KK153402/RP2040_FamicomRomdumper/docs/hardware.md

# ハードウェア仕様 / Hardware Specification（rev2）

RP2040ベースのファミコンROMダンパー（rev2基板、Booth販売用）の部品表・全接続・電源設計。**配線に関してはこの文書を正とする。**

- 組み立て後の動作確認〜ダンプ手順 → [bringup.md](bringup.md)
- 設計判断の理由と技術解説 → [design-notes.md](design-notes.md)
- シリアルコマンド仕様 → [protocol.md](protocol.md)
- rev1の既知の問題 → [../hardware/ERRATA.md](../hardware/ERRATA.md)

---

## rev1からの変更点（概要）

| 項目 | rev1 | rev2 | 理由 |
|---|---|---|---|
| MCU | ESP32-WROOM-32E DevKit | **秋月 AE-RP2040**（U13） | 無線なしで技適が不要。ネイティブUSBでドライバ不要。PIOで高速化できる |
| USB | DevKitのmicroUSB＋USB-シリアルIC | AE-RP2040のType-C（USB CDC） | Web Serialから直接使える |
| カート電源 | 旧SW1（手動スライドスイッチ） | **TPS2051C（U14）をGPIO制御** | 電源シーケンスをファームで強制する。過電流保護 |
| 過電流保護 | なし | TPS2051C（IOS 0.65〜1.05 A）＋ `CART_FLT_N` でアプリへ通知 | 故障カセット・逆挿しからUSBポートを守る |
| カート電源の監視 | なし | `VCART_SENSE`（ADC、R35/R36） | ON確認と、抜去前の放電確認 |
| 状態表示LED | なし | `LED_STATUS`（GPIO） | AE-RP2040にLEDがないため |
| `VCC_CART` 出口コンデンサ | 10 µF | **22 µF**（3216、16 V以上） | DCバイアス後の実効10 µFを確保（§9.4） |
| J1:31 | NC（ソルダージャンパ案のみ） | **SW1（SK-12D11VG3）で `VCC_CART` へ接続。出荷時ON** | ERRATA対応 |
| J1 ネット表 | ピン48の記載誤り（49が重複） | 48 = `CIRAM_CE_N_5V`、49 = `PPU_A13_N_5V` に修正 | 誤記 |

**74系IC（U1〜U12）とその周辺は rev1 から変更なし。** RP2040のI/Oは3.3 Vで5 Vトレラントではないため、レベル変換の構成はそのまま必要。

---

## 0. ネット命名規則

**74HCT244を挟む6本の制御線は、入力側と出力側で必ず別のネット名にすること。** 同名にすると、回路図上で意図せず1本に繋がっても気づけない。

| MCU側（3.3 V） | U9 経路 | カート側（5 V） | J1 |
|---|---|---|---|
| `M2_3.3V` | 1A1(2) → 1Y1(18) | `M2_5V` | 32 |
| `ROMSEL_N_3.3V` | 1A2(4) → 1Y2(16) | `ROMSEL_N_5V` | 44 |
| `RW_3.3V` | 1A3(6) → 1Y3(14) | `RW_5V` | 14 |
| `PPU_RD_N_3.3V` | 1A4(8) → 1Y4(12) | `PPU_RD_N_5V` | 17 |
| `PPU_WR_N_3.3V` | 2A1(11) → 2Y1(9) | `PPU_WR_N_5V` | 47 |
| `PPU_A13_N_3.3V` | 2A2(13) → 2Y2(7) | `PPU_A13_N_5V` | 49 |

**この12個のネットに同じノードが2つ入ってはいけない。** ERCでは検出できないので、ネットリスト出力後に目視確認すること（§11）。

### KiCadでの注意

- **ネット名に `/` を使わない。** KiCadでは階層パスの区切り文字として解釈され、ネットリスト上で `{slash}` に化ける。負論理は `_N` サフィックスで表現する（`/IRQ` ではなく `IRQ_N`）
- 電源レールは `+5V` `+3.3V` `VCC_CART` の3つ。**`VCC_CART` を `+5V` と同名にしない**

---

## 1. 実装方式

自作PCB（JLCPCB等）。ネット数が約120本あるため、ユニバーサル基板での手配線は想定しない。

---

## 2. 部品表（発注用）

### 2.1 必須部品

| # | 参照 | 部品 | 型番 | 数量 | 備考 |
|---|---|---|---|---|---|
| 1 | J1 | 60ピン カートリッジスロット | ファミコン補修用 | 1 | §3。**最も納期が長い** |
| 2 | U1–U6 | 8bitシフトレジスタ（出力） | **SN74AHCT595D**（SOIC-16） | 6 | **AHCではなくAHCT**。§2.3 |
| 3 | U7–U8 | 8bitシフトレジスタ（入力） | CD74HCT165M（SOIC-16） | 2 | AHCTファミリに `'165` は存在しない |
| 4 | U9 | オクタルバッファ | SN74AHCT244D / SN74HCT244DW | 1 | 「T」を確認 |
| 5 | U10–U12 | 1bitレベル変換 | SN74LVC1T45DBVR（SOT-23-6） | 3 | 5→3.3 V |
| 6 | U13 | RP2040ボード | **秋月 AE-RP2040**（販売コード117542） | 1 | §5 |
| 7 | U14 | 電流制限付き電源スイッチ | **TPS2051CDBVR**（SOT-23-5） | 1 | §9.3。**TPS2051C-2（放電なし）ではないこと** |
| 8 | R1–R23, R26–R34, R37, R38 | 抵抗 10 kΩ | 1608 | 34 | 内訳は§6 |
| 9 | R35, R36 | 抵抗 10 kΩ（1%推奨、5%品でも可） | 1608 | 2 | `VCART_SENSE` 分圧。§6.5 |
| 10 | R24, R25, R39 | 抵抗 1 kΩ | 1608 | 3 | LED電流制限 |
| 11 | C1–C13, C17–C20 | セラコン 0.1 µF | 1608 | 17 | U1–U12各1個＋U14 IN＋U10–U12 VCCB（C17–C19）＋J1:30直近（C20） |
| 12 | C14 | 積セラ 10 µF | 2012以上、16 V以上 | 1 | `+5V` 入口 |
| 13 | C15 | 積セラ **22 µF** | **3216、X5R/X7R、16 V以上** | 1 | `VCC_CART`（U14 OUT直近）。§9.4 |
| 14 | C16 | 積セラ 10 µF | 1608以上、10 V以上 | 1 | `+3.3V` 入口 |
| 15 | D1–D3 | LED | 1608または3 mm | 3 | `+5V` 表示 / `VCC_CART` 表示 / 状態表示 |
| 16 | SW1 | スライドスイッチ SPDT | SK-12D11VG3 | 1 | J1:31 ↔ `VCC_CART`。2=コモン（J1:31）、1=`VCC_CART`、3=NC。出荷時ON |

### 2.2 任意部品

| # | 部品 | 型番 | 数量 | 備考 |
|---|---|---|---|---|
| 17 | ピンヘッダ 1×N | 2.54 mm | 2 | AE-RP2040の実装用。キット付属分で足りるか要確認 |
| 18 | ピンソケット 1×N | 2.54 mm | 2 | AE-RP2040を着脱式にする場合（試作向き） |
| 19 | テストポイント | — | 10〜 | §5.3の空きGPIOと主要ネット |

### 2.3 発注時の最重要注意：入力しきい値に「T」が必要

**74HC595 や 74AHC595 を買うと動かない。** 必ず末尾に **T** の付く **HCT / AHCT** を発注すること。

| シリーズ | VCC = 5 V時の VIH | RP2040の3.3 V出力 |
|---|---|---|
| 74HC | 3.5 V | **認識されない（設計不成立）** |
| 74AHC | 3.85 V | **認識されない（設計不成立）** |
| 74HCT | 2.0 V | 確実に認識される |
| 74AHCT | 2.0 V | 確実に認識される |

**DigiKeyの検索結果では `SN74AHCT595D` と `SN74AHC595D` が隣接表示される。** 型番の「T」を目視確認すること。

AHCTはHCTより立ち上がりが速く（1〜2 ns）、8出力同時スイッチング時のグランドバウンスが大きい。0.1 µFのパスコンをIC直下に置き、バルクコンデンサを省略しないこと。HCTとAHCTの混在は問題ない（どちらも5 V電源・TTLしきい値）。

### 2.4 74HCT165 が入手できない場合

SN74LVC165A を VCC = 3.3 V で使う。LVCは入力が5.5 Vまで許容されるため5 Vのデータバスを直接読め、出力も3.3 Vなので **U10が不要**になる。採用する場合はU7:QHを `MISO`（GP7）へ直結し、U7/U8の電源を `+3.3V` に接続する。

---

## 3. 60ピン カートリッジスロットの調達

**代替の効かない部品。最優先で発注すること。**

| 項目 | 値 |
|---|---|
| ピッチ | 2.54 mm（0.1インチ） |
| 極数 | 30ポジション × 2列 = 60接点 |
| 受け入れ基板厚 | 0.062インチ（1.57〜1.6 mm） |
| 全長 | 約83 mm |

販売品は抜き差し回数が多いため、**接点品質と保持力を優先して選ぶ**。ファミコン補修用スロット（eBay / AliExpress、2〜4週間）を第一候補とし、ロットごとに既知のカセットで抜き差し試験をする。

---

## 4. IC一覧と役割

| 参照 | 型番 | 役割 | VCC |
|---|---|---|---|
| U1 | 74AHCT595 | CPU A7–A0 | +5V |
| U2 | 74AHCT595 | CPU A14–A8 | +5V |
| U3 | 74AHCT595 | PPU A7–A0 | +5V |
| U4 | 74AHCT595 | PPU A13–A8 | +5V |
| U5 | 74AHCT595 | CPU D7–D0（書き込み用） | +5V |
| U6 | 74AHCT595 | PPU D7–D0（書き込み用） | +5V |
| U7 | 74HCT165 | CPU D7–D0（読み出し） | +5V |
| U8 | 74HCT165 | PPU D7–D0（読み出し） | +5V |
| U9 | 74AHCT244 | 制御線6本 3.3→5 V | +5V |
| U10 | 74LVC1T45 | U7のQH 5→3.3 V | A:+3.3V / B:+5V |
| U11 | 74LVC1T45 | CIRAM A10 5→3.3 V | 同上 |
| U12 | 74LVC1T45 | CIRAM /CE 5→3.3 V | 同上 |
| U13 | AE-RP2040 | 制御、USB | 5V端子から給電 |
| U14 | TPS2051C | `VCC_CART` の開閉、過電流保護 | IN:+5V |

**U5とU6は必ず分ける。** 1個の595でCPU D0–D7とPPU D0–D7の両方を駆動すると、2本の独立したバスネットが恒久的に短絡する。

**マッパー対応（バンク切替）に必要な書き込み経路は U5/U6・R/W・/ROMSEL・M2・PPU /WR で既に揃っている。** 追加部品は不要。

### デイジーチェーン構成（rev1と同一）

```
アドレス系： MOSI → U1:SER(14)
             U1:QH'(9) → U2:SER(14) → U2:QH'(9) → U3:SER(14) → U3:QH'(9) → U4:SER(14)
             U4:QH'(9) は未接続（チェーン終端）
             RCLK は U1–U4 共通（RCLK_ADDR）

データ系：   MOSI → U5:SER(14)
             U5:QH'(9) → U6:SER(14)
             U6:QH'(9) は未接続
             RCLK は U5–U6 共通（RCLK_DATA）

読み出し系： U8:SER(10) = GND
             U8:QH(9) → U7:SER(10)
             U7:QH(9) → U10:B(4) → U10:A(3) → MISO
             /PL は U7–U8 共通（PL_165_N）

SRCLK / CP はすべてのIC（U1–U8）で SCK 共通
```

---

## 5. AE-RP2040（U13）

### 5.1 ボードの概要

| 項目 | 値 |
|---|---|
| MCU | RP2040（デュアルCortex-M0+、264 KB SRAM） |
| フラッシュ | 2 MB |
| GPIO | 30本すべて引き出し（GP0〜GP29） |
| USB | Type-C |
| 給電 | 5 V（オンボードレギュレータで3.3 V） |
| I/O電圧 | 3.3 V（**5 Vトレラントではない**） |
| 外形 | 44 × 21 mm |

### 5.1.1 ヘッダのピン配置（秋月 K-17542 ピン配置図より）

USBコネクタを上にして表から見た配置。2.54 mmピッチ、片側17ピン×2列の計34ピン。

| 左列 | 信号 | | 右列 | 信号 |
|---|---|---|---|---|
| 1 | +5V | | 34 | +3.3V |
| 2 | GP0 | | 33 | GND |
| 3 | GP1 | | 32 | GP29 |
| 4 | GP2 | | 31 | GP28 |
| 5 | GP3 | | 30 | GP27 |
| 6 | GP4 | | 29 | GP26 |
| 7 | GP5 | | 28 | GP25 |
| 8 | GP6 | | 27 | GP24 |
| 9 | GP7 | | 26 | GP23 |
| 10 | GP8 | | 25 | GP22 |
| 11 | GP9 | | 24 | GP21 |
| 12 | GP10 | | 23 | GP20 |
| 13 | GP11 | | 22 | GP19 |
| 14 | GP12 | | 21 | GP18 |
| 15 | GP13 | | 20 | GP17 |
| 16 | GP14 | | 19 | GP16 |
| 17 | GP15 | | 18 | GND |

下辺にSWD用のパッド（GND / SWDCLK / GND / SWDIO / RUN）がある。本基板では使わないが、書き込み治具を当てられるよう、**下辺の直下に部品を置かない**。

列間隔とヘッダ穴の位置は、秋月の「基板寸法図」から取ること。

**USB Type-Cが基板外形の縁に向くように配置する。** 筐体からケーブルを挿せる位置にすること。

### 5.2 ピン割り当て

PIOでまとめて扱えるよう、**用途ごとに連続したGPIOに割り当てている。** 順序を入れ替えるとファームのPIOプログラムが変わるので、変更する場合はファームと同時に直すこと。

| ヘッダ | GPIO | 信号名 | 接続先 | 方向 | PIOグループ |
|---|---|---|---|---|---|
| 4 | GP2 | `SCK` | U1–U8 の SRCLK(11) / CP(2) | OUT | side-set（連続4本） |
| 5 | GP3 | `PL_165_N` | U7–U8 の /PL(1) | OUT | side-set |
| 6 | GP4 | `RCLK_ADDR` | U1–U4 の RCLK(12) | OUT | side-set |
| 7 | GP5 | `RCLK_DATA` | U5–U6 の RCLK(12) | OUT | side-set |
| 8 | GP6 | `MOSI` | U1:SER(14)、U5:SER(14) | OUT | out |
| 9 | GP7 | `MISO` | U10:A(3) | IN | in |
| 10 | GP8 | `M2_3.3V` | U9:1A1(2) | OUT | 制御線（連続6本） |
| 11 | GP9 | `ROMSEL_N_3.3V` | U9:1A2(4) | OUT | 制御線 |
| 12 | GP10 | `RW_3.3V` | U9:1A3(6) | OUT | 制御線 |
| 13 | GP11 | `PPU_RD_N_3.3V` | U9:1A4(8) | OUT | 制御線 |
| 14 | GP12 | `PPU_WR_N_3.3V` | U9:2A1(11) | OUT | 制御線 |
| 15 | GP13 | `PPU_A13_N_3.3V` | U9:2A2(13) | OUT | 制御線 |
| 16 | GP14 | `OE_DATA_N` | U5–U6 の /OE(13) | OUT | — |
| 17 | GP15 | `BUS_EN_N` | U1–U4 の /OE(13)、U9 の 1/OE(1)・2/OE(19) | OUT | — |
| 19 | GP16 | `CIRAM_A10` | U11:A(3) | IN | — |
| 20 | GP17 | `CIRAM_CE_N` | U12:A(3) | IN | — |
| 21 | GP18 | `CART_PWR_EN` | U14:EN(4) | OUT | — |
| 22 | GP19 | `CART_FLT_N` | U14:/FLT(3) | IN | — |
| 23 | GP20 | `LED_STATUS` | R39 → D3 | OUT | — |
| 29 | GP26 | `VCART_SENSE` | R35/R36 分圧点 | IN（ADC0） | — |

**配置上の意味**：74系ロジックへの信号（GP2〜GP15）はすべて**左列（ヘッダ4〜17）** に、電源制御・監視とCIRAM（GP16〜GP20、GP26）は**右列**にまとまる。U1〜U9は左列側に、U11/U12・U14は右列側に置くと配線が素直になる。

### 5.3 予約・空きピン

| GPIO | 扱い |
|---|---|
| GP0 / GP1（ヘッダ2 / 3） | **UART0（TX/RX）としてデバッグ用に予約。** テストポイントだけ出す。USB CDCが動かないときの切り分けに使う |
| GP21–GP25（ヘッダ24〜28）、GP27–GP29（ヘッダ30〜32） | 空き。テストポイントを置く |

RP2040にはESP32のようなストラップピンはない（BOOTSELはボード上のボタン）。GP0〜GP29のどれを使っても起動モードには影響しない。

### 5.4 電源端子

| ヘッダ | AE-RP2040の端子 | 接続先 | 備考 |
|---|---|---|---|
| 1 | +5V | `+5V` | **基板全体の5 V源**。VBUSからSBD経由 |
| 34 | +3.3V | `+3.3V` | U10–U12のVCCA、3.3 V側プル抵抗、R38 |
| 18, 33 | GND | GND | **両方とも接続する**。GND端子はこの2本だけなので、それぞれ太いパターンとビア複数でGNDプレーンへ |

### 5.4.1 VBUS → +5V のショットキーダイオード

AE-RP2040の回路図では、USB-C（CN5）のVBUSから**ショットキーバリアダイオード（SBD）を経由して** 5V端子に出ている。したがって `+5V` = VBUS − VF となる。

| 条件 | VBUS | VF（SBD、約0.3 A時の目安） | `+5V` |
|---|---|---|---|
| 一般的なPCのUSBポート | 5.0 V | 0.3〜0.4 V | **4.6〜4.7 V** |
| USB 2.0の下限 | 4.75 V | 0.4 V | **4.35 V** |

- 74HCT/AHCT・TPS2051Cの推奨VCCは4.5〜5.5 V。通常の条件では満たす。下限条件では仕様を割るが、HCT/AHCTの入力しきい値（TTLレベル、約1.4 V）はVCCにほとんど依存せず、RP2040の3.3 V出力に対する余裕は大きいので、動作上の問題は出にくい
- TPS2051CのUVLO（立ち上がり最大4.0 V）には余裕がある
- **出荷検査で `+5V` を実測する**（カート電源ON・ダンプ中）。4.5 V以上を合格基準とする
- 説明書には「PC本体のUSBポートに直接接続。バスパワーのUSBハブ経由は非推奨」と書く
- **SBDの電流定格を回路図で確認する。** 通常は最大約0.3 Aだが、カート短絡時はTPS2051Cの制限値（最大1.05 A）＋基板分で最大約1.2 Aが、/FLTで遮断するまでの最大12 ms流れる。定格1 A品でも、この程度のパルスなら通常は問題ない

### 5.5 リセット中の状態

RP2040のGPIOはリセット直後、**入力・内部プルダウン有効**（RP2040データシート PADS_BANK0：PDE=1、PUE=0。内部プルダウンは約50〜80 kΩ）になっている。ファームが起動するまでの間に信号が不定にならないよう、外付け抵抗で状態を決める（§6）。

10 kΩのプルアップと内部プルダウンが競合した場合の電圧（プルダウン最小50 kΩで計算）：

V = 3.3 V × 50 kΩ ÷ (10 kΩ + 50 kΩ) = **2.75 V**

接続先は74AHCT/HCTの入力（VIH = 2.0 V）なので、Hとして確実に認識される。

### 5.6 USBの消費電流

| 状態 | 内訳 | 合計目安 |
|---|---|---|
| 接続直後（カート電源OFF） | RP2040約25 mA＋74系の静止電流 | 約30 mA |
| 動作中（カート電源ON） | 上記＋74系の動作電流100〜150 mA＋カセット60〜115 mA | 最大約300 mA |

USB 2.0の上限500 mAに収まる。USBディスクリプタのbMaxPowerは500 mAとする（列挙前は100 mA以内に収まっている）。

---

## 6. 抵抗の配置

### 6.1 データバスのプルアップ（5 V側）

| 参照 | 値 | 接続 | 目的 |
|---|---|---|---|
| R1–R8 | 10 kΩ | `CPU_D0`–`CPU_D7` ↔ **`VCC_CART`** | オープンバス = `$FF` を明示検出 |
| R9–R16 | 10 kΩ | `PPU_D0`–`PPU_D7` ↔ **`VCC_CART`** | 同上 |

**吊り先は `+5V` ではなく `VCC_CART`。** `+5V` に吊ると、カート電源をOFFにしても16本の10 kΩ経由で無電源のカセットへ電流が流れ込み（1本あたり約0.4 mA）、カート側の保護ダイオード経由でVCCが弱く逆給電される。

### 6.2 244 入力側の整定（3.3 V側）

**RP2040のリセット中はGPIOが入力（内部プルダウン）になるため、外付け抵抗で非アクティブ側に確定させる。**

| 参照 | 値 | ネット | 接続先 |
|---|---|---|---|
| R17 | 10 kΩ | `M2_3.3V` | **GND**（L = 非アクティブ） |
| R26 | 10 kΩ | `ROMSEL_N_3.3V` | **+3.3V** |
| R27 | 10 kΩ | `RW_3.3V` | **+3.3V**（H = リード） |
| R28 | 10 kΩ | `PPU_RD_N_3.3V` | **+3.3V** |
| R29 | 10 kΩ | `PPU_WR_N_3.3V` | **+3.3V** |
| R30 | 10 kΩ | `PPU_A13_N_3.3V` | **+3.3V** |

### 6.3 244 出力側の整定（5 V側）

**`BUS_EN_N` でU9をHi-Zにしたとき、カート側の制御線が浮くのを防ぐ。**

| 参照 | 値 | ネット | 接続先 |
|---|---|---|---|
| R32 | 10 kΩ | `M2_5V` | **GND** |
| R18 | 10 kΩ | `ROMSEL_N_5V` | **`VCC_CART`** |
| R19 | 10 kΩ | `RW_5V` | **`VCC_CART`** |
| R20 | 10 kΩ | `PPU_RD_N_5V` | **`VCC_CART`** |
| R21 | 10 kΩ | `PPU_WR_N_5V` | **`VCC_CART`** |
| R22 | 10 kΩ | `PPU_A13_N_5V` | **`VCC_CART`** |

**3.3 Vに吊ってはいけない。** Hi-Z時にカート側CMOSのVIH（VCC = 5 V時に3.5 V）を満たさない。**`+5V` ではなく `VCC_CART` に吊る**理由は§6.1と同じ。

### 6.3.1 CIRAM 2本のプルアップ

| 参照 | 値 | ネット | 接続先 |
|---|---|---|---|
| R33 | 10 kΩ | `CIRAM_A10_5V` | **`VCC_CART`** |
| R34 | 10 kΩ | `CIRAM_CE_N_5V` | **`VCC_CART`** |

U11:B(4) と U12:B(4) は入力ピンで、カート未挿入時に浮く。LVCの入力を浮かせると消費電流の増加と発振の原因になる。

### 6.4 MCU制御線・電源制御

| 参照 | 値 | ネット | 接続先 | 目的 |
|---|---|---|---|---|
| R23 | 10 kΩ | `OE_DATA_N` | **+3.3V** | リセット中はU5/U6をHi-Z |
| R31 | 10 kΩ | `BUS_EN_N` | **+3.3V** | リセット中はU1–U4・U9をHi-Z |
| R37 | 10 kΩ | `CART_PWR_EN` | **GND** | **リセット中はカート電源OFF** |
| R38 | 10 kΩ | `CART_FLT_N` | **+3.3V** | /FLTはオープンドレイン |
| R24 | 1 kΩ | `+5V` → D1 | — | `+5V` 電源表示 |
| R25 | 1 kΩ | `VCC_CART` → D2 | — | カート通電表示 |
| R39 | 1 kΩ | `LED_STATUS` → D3 | — | 状態表示 |

- **R23 / R31 は3.3 Vに吊る。** RP2040は5 Vトレラントでない
- **R37はプルダウン。** TPS2051CのENはアクティブH（データシート Table 5-2）。ENのしきい値は立ち上がりで1.0〜2.0 V（§6.7）なので、3.3 V出力でON、R37と内部プルダウンでOFFが確定する
- **R38は `+3.3V` に吊る。** `+5V` に吊ると、GP19に5 Vが入る
- LED電流：D1/D2 は (5 − 2) V ÷ 1 kΩ ≈ 3 mA、D3 は (3.3 − 2) V ÷ 1 kΩ ≈ 1.3 mA。D3が暗い場合はR39を470 Ωにする

### 6.5 `VCART_SENSE`（カート電源の監視）

| 参照 | 値 | 接続 |
|---|---|---|
| R35 | 10 kΩ 1% | `VCC_CART` → `VCART_SENSE` |
| R36 | 10 kΩ 1% | `VCART_SENSE` → GND |

分圧比1/2。`VCC_CART` = 5.5 V（USB上限）でも2.75 Vで、ADC入力の上限（IOVDD = 3.3 V）を超えない。

用途：

- ON後に `VCC_CART` ≥ 4.0 V（ADC読みで2.0 V以上）を確認してから `BUS_EN_N` = L にする

**判定しきい値は4.0 Vとする（4.5 Vにしない）。** `+5V` 自体がSBDの降下で4.6〜4.7 Vしかない（§5.4.1）。4.5 Vで判定すると、分圧抵抗の誤差（5%品で比率最大±5%）とADC基準（+3.3V）の誤差だけで正常品をNGにする。4.0 VならTPS2051CのUVLO（最大4.0 V）と揃い、電流制限中（出力電圧が大きく下がる）との区別には十分。

| 抵抗 | 分圧比の最悪誤差 | `VCC_CART` = 4.6 V時のADC読み | 4.0 V判定（2.0 V）の余裕 |
|---|---|---|---|
| 5%品 | ±5% | 2.18〜2.42 V | 0.18 V以上 |
| 1%品 | ±1% | 2.27〜2.33 V | 0.27 V以上 |

- OFF後に `VCC_CART` < 0.5 V（ADC読みで0.25 V未満）を確認してから、アプリが「カセットを抜いてください」と表示する

**10 kΩの合計：16 + 6 + 6 + 2 + 2 + 2 = 34本**（R35/R36の1%品を除く）

---

## 7. 60ピン 全ネット表

```
[表面 01-30]                                    [裏面 31-60]
01 GND           = GND                          31 CART_PIN31       = SW1:2（ON時 VCC_CART）, TP13
02 CPU_A11       = U2:QD(3)                     32 M2_5V            = U9:1Y1(18), R32
03 CPU_A10       = U2:QC(2)                     33 CPU_A12          = U2:QE(4)
04 CPU_A9        = U2:QB(1)                     34 CPU_A13          = U2:QF(5)
05 CPU_A8        = U2:QA(15)                    35 CPU_A14          = U2:QG(6)
06 CPU_A7        = U1:QH(7)                     36 CPU_D7  = U5:QH(7),  U7:H(6),  R1
07 CPU_A6        = U1:QG(6)                     37 CPU_D6  = U5:QG(6),  U7:G(5),  R2
08 CPU_A5        = U1:QF(5)                     38 CPU_D5  = U5:QF(5),  U7:F(4),  R3
09 CPU_A4        = U1:QE(4)                     39 CPU_D4  = U5:QE(4),  U7:E(3),  R4
10 CPU_A3        = U1:QD(3)                     40 CPU_D3  = U5:QD(3),  U7:D(14), R5
11 CPU_A2        = U1:QC(2)                     41 CPU_D2  = U5:QC(2),  U7:C(13), R6
12 CPU_A1        = U1:QB(1)                     42 CPU_D1  = U5:QB(1),  U7:B(12), R7
13 CPU_A0        = U1:QA(15)                    43 CPU_D0  = U5:QA(15), U7:A(11), R8
14 RW_5V         = U9:1Y3(14), R19              44 ROMSEL_N_5V      = U9:1Y2(16), R18
15 IRQ_N         = NC                           45 Audio_from_2A03  = NC
16 GND           = GND                          46 Audio_to_RF      = NC
17 PPU_RD_N_5V   = U9:1Y4(12), R20              47 PPU_WR_N_5V      = U9:2Y1(9), R21
18 CIRAM_A10_5V  = U11:B(4), R33                48 CIRAM_CE_N_5V    = U12:B(4), R34
19 PPU_A6        = U3:QG(6)                     49 PPU_A13_N_5V     = U9:2Y2(7), R22
20 PPU_A5        = U3:QF(5)                     50 PPU_A7           = U3:QH(7)
21 PPU_A4        = U3:QE(4)                     51 PPU_A8           = U4:QA(15)
22 PPU_A3        = U3:QD(3)                     52 PPU_A9           = U4:QB(1)
23 PPU_A2        = U3:QC(2)                     53 PPU_A10          = U4:QC(2)
24 PPU_A1        = U3:QB(1)                     54 PPU_A11          = U4:QD(3)
25 PPU_A0        = U3:QA(15)                    55 PPU_A12          = U4:QE(4)
26 PPU_D0 = U6:QA(15), U8:A(11), R9             56 PPU_A13          = U4:QF(5)
27 PPU_D1 = U6:QB(1),  U8:B(12), R10            57 PPU_D7 = U6:QH(7), U8:H(6),  R16
28 PPU_D2 = U6:QC(2),  U8:C(13), R11            58 PPU_D6 = U6:QG(6), U8:G(5),  R15
29 PPU_D3 = U6:QD(3),  U8:D(14), R12            59 PPU_D5 = U6:QF(5), U8:F(4),  R14
30 VCC_CART      = U14:OUT(1), C15, C20, R25, R35   60 PPU_D4 = U6:QE(4), U8:E(3),  R13
```

空き出力：U2:QH(7)、U4:QG(6)、U4:QH(7) → 未接続でよい。

**ピン15（`IRQ_N`）**：マッパー対応後もダンプには使わない。MMC3等のIRQ動作確認を将来やる場合に備え、テストポイントだけ出しておくとよい。

**ピン31について**：NESdev Wikiによると、ファミコン本体のピン31は版によって「+5V」または「RFモジュレータのTV/GAME切替（カセットがピン30–31をつないだときだけ映像が出る）」である。多くのカセットは基板上でピン30とピン31をつないでおり、ピン31に+5Vが来る本体も存在するため、**ピン31に `VCC_CART` を与えて壊れるカセットはない**。SW1は出荷時ONとし、ピン31からしか電源を取らないカセットにも対応する。**SW1の接続先は `+5V` ではなく `VCC_CART`。** `+5V` にすると、カート電源OFF中もピン31からカセットに給電され、電源シーケンス（§9.5）が成立しなくなる。

---

## 8. IC共通ピンの処理（rev1と同一）

### 8.1 74AHCT595（U1–U6）

| ピン | 名称 | 処理 |
|---|---|---|
| 8 | GND | GND |
| 9 | QH'（シリアル出力） | 次段のSER(14)へ。U4・U6は未接続 |
| 10 | /SRCLR | **+5V**（リセットしない） |
| 11 | SRCLK | `SCK` 共通 |
| 12 | RCLK | U1–U4 = `RCLK_ADDR` / U5–U6 = `RCLK_DATA` |
| 13 | /OE | U1–U4 = **`BUS_EN_N`** / U5–U6 = `OE_DATA_N` |
| 14 | SER | 前段のQH'(9)、または U1・U5 は `MOSI` |
| 16 | VCC | +5V |

出力ビットの対応：**MSBファーストで送ると bit7 → QH、bit0 → QA**。

### 8.2 74HCT165（U7–U8）— パラレル入力のマッピングに注意

165は **A → B → … → H → QH** の順にシフトするため、**H（ピン6）が最初に出力される**。

| ピン | 記号 | 出力される順番 | 接続 |
|---|---|---|---|
| 11 | A | 8番目（最後） | **D0** |
| 12 | B | 7番目 | **D1** |
| 13 | C | 6番目 | **D2** |
| 14 | D | 5番目 | **D3** |
| 3 | E | 4番目 | **D4** |
| 4 | F | 3番目 | **D5** |
| 5 | G | 2番目 | **D6** |
| 6 | H | 1番目（最初） | **D7** |

| ピン | 名称 | 処理 |
|---|---|---|
| 1 | /PL（SH//LD） | `PL_165_N` 共通 |
| 2 | CP（CLK） | `SCK` 共通 |
| 7 | /QH | 未接続 |
| 8 | GND | GND |
| 9 | QH | U8 → U7:SER(10) / U7 → U10:B(4) |
| 10 | SER | U8 = **GND** / U7 = U8:QH(9) |
| 15 | CLK INH（/CE） | **GND** |
| 16 | VCC | +5V |

### 8.3 74AHCT244（U9）

| ピン | 名称 | 処理 |
|---|---|---|
| **1** | **1/OE** | **`BUS_EN_N`。未接続にしない** |
| **19** | **2/OE** | **`BUS_EN_N`** |
| 10 | GND | GND |
| 20 | VCC | +5V |
| 15, 17 | 2A3, 2A4（未使用入力） | **GND** |
| 3, 5 | 2Y3, 2Y4（未使用出力） | 未接続 |

### 8.4 74LVC1T45（U10–U12、SOT-23-6）

| ピン | 名称 | 処理 |
|---|---|---|
| 1 | VCCA | **+3.3V** |
| 2 | GND | GND |
| 3 | A | MCU側（出力） |
| 4 | B | 5 V側（入力） |
| 5 | DIR | **GND**（B→A固定） |
| 6 | VCCB | **+5V** |

### 8.5 TPS2051C（U14、SOT-23-5）

ピン配置は TPS20xxC データシート（SLVSAU6I）Table 5-2 による。

| ピン | 名称 | 処理 |
|---|---|---|
| 1 | OUT | **`VCC_CART`**、C15（22 µF）を直近に |
| 2 | GND | GND |
| 3 | /FLT | `CART_FLT_N`（GP19）、R38で+3.3Vへ |
| 4 | EN | `CART_PWR_EN`（GP18）、R37でGNDへ。**アクティブH** |
| 5 | IN | **`+5V`**、C13（0.1 µF）を直近に |

**型番末尾に注意：TPS2051C は出力放電あり、TPS2051C-2 は放電なし。** 本設計は放電機能を前提にしている（§9.5）ので、**-2なしを発注すること。**

---

## 9. 電源系統

### 9.1 レール構成

| レール | 供給元 | 供給先 | 電流目安 |
|---|---|---|---|
| `+5V`（常時） | AE-RP2040の+5V端子（ヘッダ1。VBUSからSBD経由） | U1–U9のVCC、U10–U12のVCCB、/SRCLR、U14:IN、R24/D1 | 100〜150 mA（カート分を除く） |
| `+3.3V` | AE-RP2040の3V3端子 | U10–U12のVCCA、R23・R26–R31・R38 | 数 mA |
| `VCC_CART` | `+5V` から **U14（TPS2051C）** 経由 | **J1:30、SW1:1、C15、C20、カート側プル抵抗 R1–R16・R18–R22・R33–R34、R25/D2、R35/R36** | 60〜115 mA |

`VCC_CART` にICのVCCが入り込んでいたら誤り。逆に、カート側の信号に付くプル抵抗は**すべて** `VCC_CART` に吊ること。

### 9.2 カート電源を独立レールにする理由

**`+5V` 全体を遮断してはいけない。** RP2040はUSBから給電されて動き続けるため、電源の落ちた74AHCT/HCTの入力ピンに3.3 Vを叩き込む状態になる。入力保護ダイオード経由でVCCラインに電流が流れ込み、ICが中途半端に起動したりラッチアップの原因になる。

**遮断するのは `VCC_CART` だけ。** U1–U12は常時給電のままにする。

### 9.3 TPS2051C（U14）の選定根拠

| 項目 | 値（SLVSAU6I §6.7、§6.8） | 本設計での意味 |
|---|---|---|
| ENの極性 | アクティブH | R37でプルダウン。リセット中はOFF |
| ENしきい値（立ち上がり） | 1.0〜2.0 V（ヒステリシス0.07〜0.2 V） | 3.3 V出力で確実にON |
| 電流制限 IOS | **0.65〜1.05 A**（0.5 A定格品） | 下記 |
| 短絡応答 | 2 µs（typ） | — |
| /FLT デグリッチ | 6〜12 ms | 突入電流では /FLT が出ない |
| 出力放電抵抗 RPD | 300〜800 Ω（VIN = 5 V、OFF時） | §9.5 |
| 立ち上がり時間 tR | 0.4〜0.7 ms（CL = 1 µF、RL = 100 Ω） | 突入電流の計算に使う |
| オン抵抗 | 97 mΩ typ / 154 mΩ max | 115 mA × 154 mΩ = **18 mV** の降下。無視できる |
| 逆流防止 | あり | — |
| UVLO（立ち上がり） | 3.5〜4.0 V | — |

**電流制限値について：「0.5 A定格」は連続で流せる電流であり、制限が働くのは0.65〜1.05 A。** 短絡時はUSBポートから最大1.05 A＋基板分約0.15 A ≒ **1.2 A** が流れる。USB 2.0の500 mAを超えるが、以下で時間を限っている。

1. /FLT デグリッチ（最大12 ms）後にファームがENをLにする
2. ファームが止まっていても、ICの過熱保護（制限中は135 °C）で遮断する

PCのUSBポート側の保護（ポリスイッチ等）が先に動くことはあっても、ポートが壊れることはない。制限値をUSBの500 mA以内にしたい場合は、ILIM抵抗で設定できる TPS2553 に替える（ピン配置が異なるので要再設計）。

### 9.4 コンデンサ

| 参照 | 値 | 配置 | 根拠 |
|---|---|---|---|
| C1–C12 | 0.1 µF | 各IC（U1–U12）のVCC–GND間に最短配置。IC直下の裏面 | — |
| C13 | 0.1 µF | U14:IN(5)直近 | データシート Table 5-2：IN–GND間に0.1 µF以上 |
| C14 | 10 µF | `+5V` 入口（AE-RP2040の5V端子付近） | AHCTの同時スイッチング対策 |
| C15 | **22 µF、3216、16 V以上** | U14:OUT(1)直近 | 下記 |
| C16 | 10 µF | `+3.3V` 入口 | — |
| C17–C19 | 0.1 µF | U10–U12のVCCB（+5V）直近 | 1T45データシート推奨 |
| C20 | 0.1 µF | **J1:30直近**（`VCC_CART`） | U14→J1:30は約100 mmの配線でインダクタンスがあるため、カセット側の局所デカップリングとして追加 |

**C15の容量について。** データシート §8.2.2.1 では、USB規格の下流ポート（ケーブル経由で機器が付く）には120 µF以上を求めている。本機の負荷は基板上のカセットだけでケーブルのインダクタンスがないため、同節の「120 µF不要なら最低10 µFのセラミック」に該当する。

10 µFはDCバイアス後の実効値として確保する。1608の10 µFは5 V印加で実効3〜4 µFまで下がるため、**3216の22 µF（5 V印加で実効10 µF以上）** とする。実効値は村田製作所のSimSurfing等で確認すること。

**突入電流の確認。** TPS2051Cは出力の立ち上がりをチャージポンプで制御するため、突入電流はおおむね C × ΔV ÷ tR で決まる。

- 10–90%の電圧変化 ΔV = 4 V、tR最小 = 0.4 ms
- C15（22 µF）：22 µF × 4 V ÷ 0.4 ms = **0.22 A**
- カセット側のパスコン（数 µF程度）と負荷電流115 mAを足しても約0.4 A

IOS最小0.65 Aに対して余裕があり、ON時に電流制限に入らない。仮に一瞬入っても、/FLTのデグリッチ（6 ms以上）の間に収まる。

### 9.5 電源シーケンス

ファームが以下を必ず守る。**ユーザーは手順を意識しなくてよい。**

```
起動時：
  1. BUS_EN_N = H、OE_DATA_N = H、制御線は非アクティブ（確認）
  2. CART_PWR_EN = H
  3. 10 ms待つ（tON最大1.8 ms＋tR最大0.7 msに余裕を持たせる）
  4. CART_FLT_N = H かつ VCART_SENSE ≥ 2.0 V（VCC_CART ≥ 4.0 V）を確認
     → NGなら CART_PWR_EN = L にして「カセット異常」を通知して終了
  5. BUS_EN_N = L

終了時：
  1. OE_DATA_N = H、制御線を非アクティブに
  2. BUS_EN_N = H
  3. CART_PWR_EN = L
  4. VCART_SENSE < 0.25 V（VCC_CART < 0.5 V）になるまで待つ（タイムアウト200 ms）
  5. アプリに「カセットを抜いてください」を通知

動作中の常時監視：
  CART_FLT_N = L を検出したら、直ちに 終了時の 1〜3 を実行し、「過電流」を通知
```

**終了時の放電時間。** TPS2051CのOFF時は内部放電抵抗RPD（300〜800 Ω）が `VCC_CART` を引き下げる。カセットを除いた最悪条件（RPD = 800 Ω、C = 22 µF）では、

- 時定数 τ = 800 Ω × 22 µF = 17.6 ms
- 5 V → 0.5 V：t = τ × ln(5 ÷ 0.5) = 17.6 ms × 2.30 = **約41 ms**

実際はカセットの消費電流とR35/R36・R25/D2も放電を早めるので、これより短い。タイムアウト200 msは十分な余裕を持たせた値。

---

## 10. 発注チェックリスト（基板1枚あたり、括弧内は試作3枚分の推奨数）

```
[ ] 60ピンカートリッジスロット ×1（×4）          ← 納期が長いので最優先
[ ] 秋月 AE-RP2040 ×1（×4）
[ ] TPS2051CDBVR ×1（×5）                        ← 「-2」なし（放電あり）を確認
[ ] SN74AHCT595D ×6（×20）                       ← AHC ではなく AHCT
[ ] CD74HCT165M ×2（×8）
[ ] SN74AHCT244D または SN74HCT244DW ×1（×4）    ← 「T」を確認
[ ] SN74LVC1T45DBVR ×3（×10）
[ ] 抵抗 10 kΩ 1608 ×34（100本入り1袋）
[ ] 抵抗 10 kΩ 1% 1608 ×2（×10）
[ ] 抵抗 1 kΩ 1608 ×3（×20）
[ ] セラコン 0.1 µF 1608 ×13（×50）
[ ] 積セラ 10 µF ×2（×10）
[ ] 積セラ 22 µF 3216 16 V以上 ×1（×5）
[ ] LED ×3（×10）
[ ] ピンヘッダ / ピンソケット（AE-RP2040実装用）
```

---

## 11. ネットリストのセルフチェック

KiCadのERCでは検出できない誤りが多いため、ネットリスト出力後に以下を確認する。

### 11.1 バッファの入出力短絡

**§0の12ネットを1本ずつ確認し、各ネットにU9のノードが1つだけであることを確かめる。**

```
NG例： M2 [5] U13.GP8 , U9.2(1A1) , U9.18(1Y1) , J1.32 , R17
                       ~~~~~~~~~~~~~~~~~~~~~~~ 入力と出力が同じネット
OK例： M2_3.3V [3] U13.GP8 , U9.2(1A1) , R17
       M2_5V   [3] U9.18(1Y1) , J1.32 , R32
```

入出力が短絡すると、**RP2040のGPIOがカセットの5 Vラインに直結し、GPIOが破壊される。**

### 11.2 未接続ピンの一覧を全部読む

| 意図的に未接続でよい | 未接続にしてはいけない |
|---|---|
| U2:QH(7)、U4:QG(6)、U4:QH(7)、U4:QH'(9)、U6:QH'(9) | **U9:1/OE(1)、U9:2/OE(19)** |
| U7/U8:/QH(7)、U9:2Y3(5)、U9:2Y4(3) | **U9:2A3(15)、U9:2A4(17)**（GNDへ） |
| J1:15、45、46 | すべての /OE、/PL、/SRCLR、CLK INH |
| U13の空きGPIO（§5.3） | **U14:EN(4)、U14:/FLT(3)** |

### 11.3 165のビット順

§8.2の表と照合。**ピン11 = D0、ピン6 = D7**。

### 11.4 RP2040のピン割り当て

- §5.2の表と1本ずつ照合する。**PIOのグループ（GP2–5、GP6–7、GP8–13）が連続していること**
- GP0 / GP1 に信号を割り当てていないこと（デバッグUART用）

### 11.5 電源レール

- `VCC_CART` に **ICのVCCが入り込んでいない**こと。入ってよいのは U14:OUT、J1:30、SW1:1、C20、カート側プル抵抗（R1–R16、R18–R22、R33–R34）、C15、R25/D2、R35/R36 のみ
- **カート側信号に付くプル抵抗が `+5V` に吊られていない**こと
- **SW1の接点が `+5V` やGNDになっていない**こと（1=`VCC_CART`、2=J1:31、3=NC）
- `+3.3V` 側のプル抵抗（R23、R26–R31、R38）が誤って `+5V` に吊られていないこと

### 11.6 レベル変換ICの入力が浮いていないか

`U11:B(4)` と `U12:B(4)` に `VCC_CART` へのプルアップ（R33 / R34）があること。

### 11.7 TPS2051C

- ピン1 = OUT、ピン5 = IN（**SOT-23-5の標準的なLDOと配置が異なるので、汎用フットプリントの流用に注意**）
- ENがGP18とR37（GND）、/FLTがGP19とR38（+3.3V）に接続されていること

---

## 12. 基板レイアウトの注意

| 項目 | 内容 |
|---|---|
| U14まわり | C13をIN、C15をOUTに最短で。`+5V` → U14 → J1:30 の経路は電流が流れるので太め（0.5 mm以上）に |
| `SCK` | 8個のICに分配するクロック。PIOで高速化（MHz級）するので、**分岐を短く、GNDプレーン上を通す**。必要なら AE-RP2040の直近に直列抵抗（22〜33 Ω）のパターンを用意しておく |
| GNDプレーン | 裏面ベタGND。74系ICのGNDピンはビアで最短接続 |
| J1 | カセットの外装が基板や部品に当たらないよう、J1周辺に背の高い部品を置かない |
| AE-RP2040 | Type-Cを基板端に向ける。BOOTSELボタンに筐体の外から届くようにする |
| テストポイント | `+5V`、`+3.3V`、`VCC_CART`、GND、`SCK`、`MISO`、GP0/GP1、空きGPIO |

---

## 13. 既知の注意点

1. **末尾に「T」の付くHCT / AHCTを使う。** 74HC・74AHCではVIHが3.5〜3.85 Vとなり3.3 Vでは動かない
2. **244の入力側と出力側を同じネット名にしない**
3. **U9の1/OE(1)と2/OE(19)を未接続にしない**
4. **165のピン11 = D0、ピン6 = D7**
5. **U5とU6を1個にまとめない**
6. **カート電源だけを独立レールにする**
7. **OE_DATA_N / BUS_EN_N / CART_FLT_N のプルアップは3.3 V。** RP2040は5 Vトレラントでない
8. **244出力側のプルアップは `VCC_CART`。** 3.3 Vではカート側CMOSのVIHを満たさない
9. **カート側のプル抵抗はすべて `VCC_CART` に吊る**
10. **U11:B / U12:B にプルアップを付ける**
11. **1T45のVCCA / VCCBを取り違えない**
12. **244の未使用入力（2A3, 2A4）はGNDへ**
13. **ネット名に `/` を使わない**
14. **AHCTはバルクコンデンサを省略しない**
15. **165の読み出しはQHを読んでからクロックを入れる。** SPI MODE0相当の「同じ立ち上がりでサンプル」では先頭ビットが欠ける（rev1で確認済み）。PIOでも順序を守ること
16. **TPS2051C「-2」を使わない。** 出力放電がなく、OFF後に `VCC_CART` が残る
17. **CART_PWR_EN はプルダウン。** リセット中にカート電源が入らないようにする
18. **SW1は `VCC_CART` 側へ。残りの接点はNC。** `+5V` にすると電源シーケンスが崩れ、GNDにするとピン30–31を短絡しているカセットで `VCC_CART` が短絡する
19. **AE-RP2040の5V端子はVBUSからSBD経由。** 出荷検査で `+5V` ≥ 4.5 V を確認する（§5.4.1）
20. **GP0 / GP1 はデバッグUART用に空けておく**

---

## 改訂履歴

| 版 | 内容 |
|---|---|
| rev1 設計 | 初版。ESP32 + 74HCT595/165 + 74HCT244 構成 |
| rev1 レビュー1 | 244の入出力ネット分離、165のパラレル入力順の明示、`VCC_CART` 独立レール化、`BUS_EN_N` 追加、GPIO3の使用取りやめ |
| rev1 レビュー2 | カート側プル抵抗を `VCC_CART` へ、CIRAM 2本のプルアップ（R33/R34）追加 |
| rev1 実機 | 全経路の動作確認完了。165の読み出しをビットバングに変更（ファームのみ） |
| **rev2 設計** | MCUをAE-RP2040へ変更（PIO前提のピン割り当て）。旧SW1（手動カート電源）をTPS2051Cに置き換え、`CART_FLT_N`・`VCART_SENSE`・状態LEDを追加。C15を22 µFへ。ネット表のピン48の誤記を修正。J1:31はSW1（出荷時ON）で `VCC_CART` へ |
