KK153402/RP2040_FamicomRomdumper/hardware/component/CD74HCT165M96/CD74HCT165M96.stp

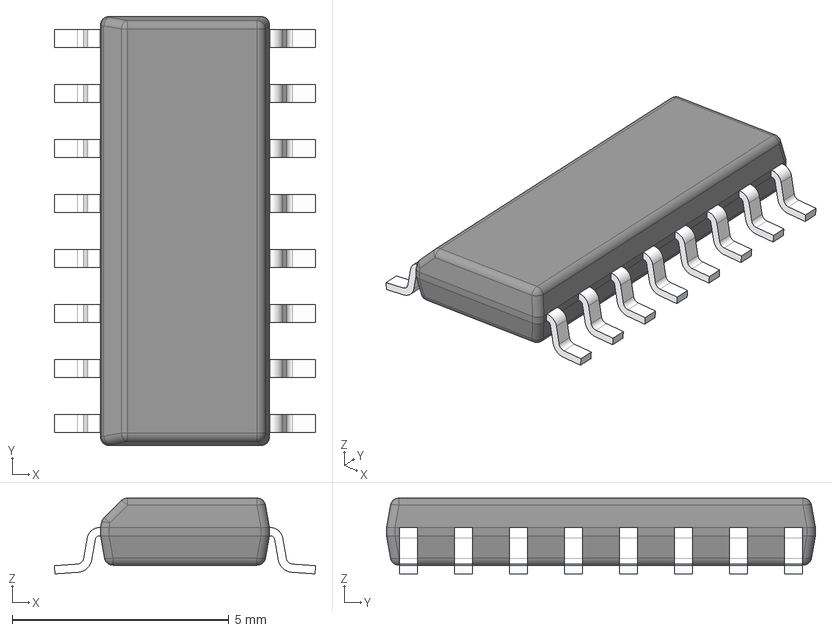
[picture p1: CAD file, 2026-10-24]
hardware/component/CD74HCT165M96/CD74HCT165M96.stp
6.03 x 9.90 x 1.75 mm
BODY-SO
LEAD-SO x 16
PIN1-ID
