KK153402/RP2040_FamicomRomdumper/hardware/component/E12P8WT86/SML-E12P8WT86.stp

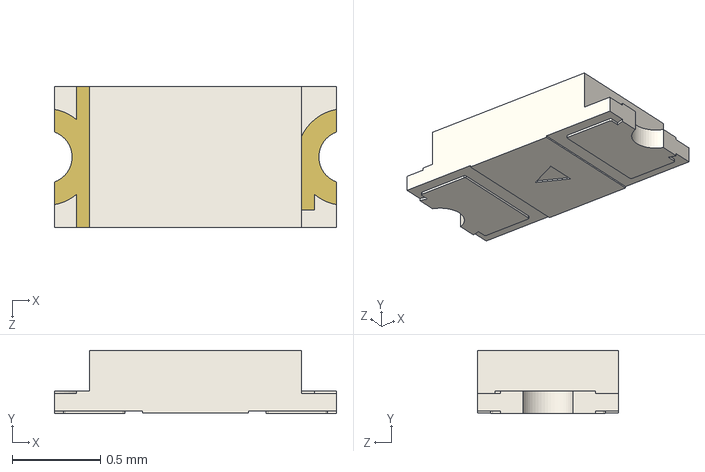
[picture p2: CAD file, 2026-10-24]
hardware/component/E12P8WT86/SML-E12P8WT86.stp
1.60 x 0.36 x 0.8 mm
