KK153402/RP2040_FamicomRomdumper/hardware/component/SN74AHCT244DWR/SN74AHCT244DWR.step

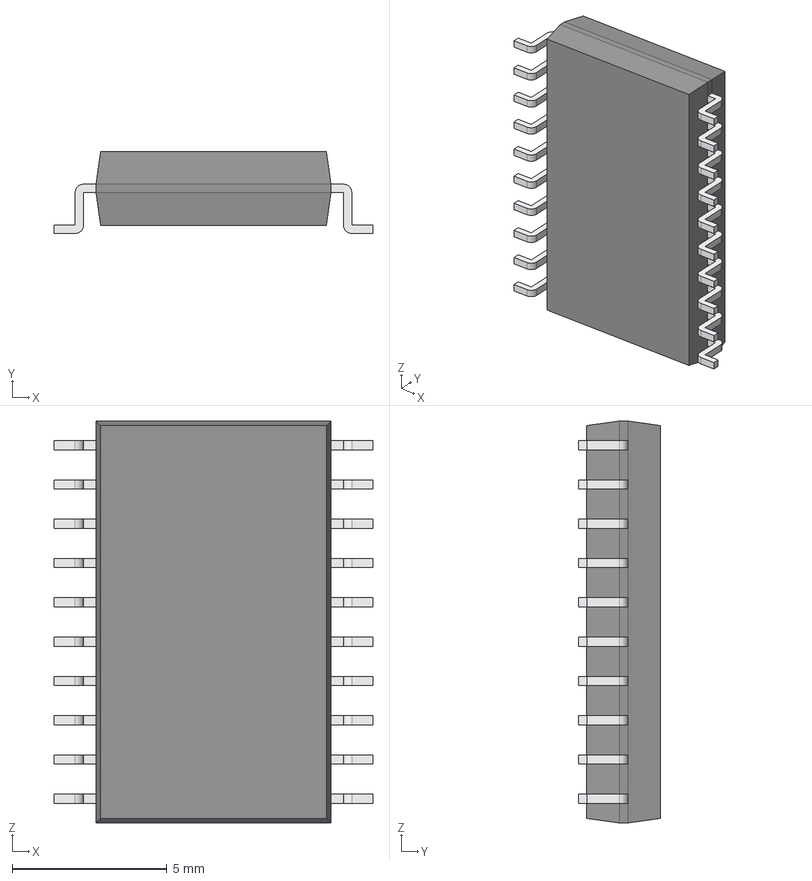
[picture p3: CAD file, 2026-10-24]
hardware/component/SN74AHCT244DWR/SN74AHCT244DWR.step
10.3 x 2.65 x 13.0 mm
Body001 (Mirror #1) x 10
XY-plane x 12
X-axis x 12
