KK153402/RP2040_FamicomRomdumper/hardware/component/SN74AHCT595D/SN74AHCT595D.step

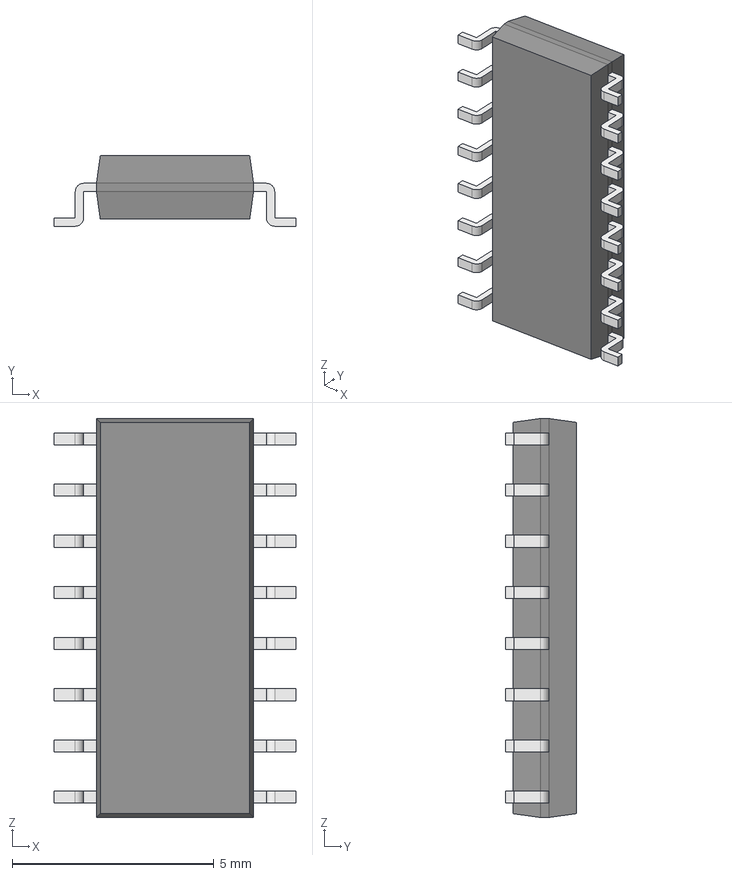
[picture p4: CAD file, 2026-10-24]
hardware/component/SN74AHCT595D/SN74AHCT595D.step
6.00 x 1.75 x 9.90 mm
Body001 (Mirror #1) x 8
XY-plane x 12
X-axis x 12
