KK153402/RP2040_FamicomRomdumper/hardware/component/SN74LVC1T45DBVR/SN74LVC1T45DBVR.step

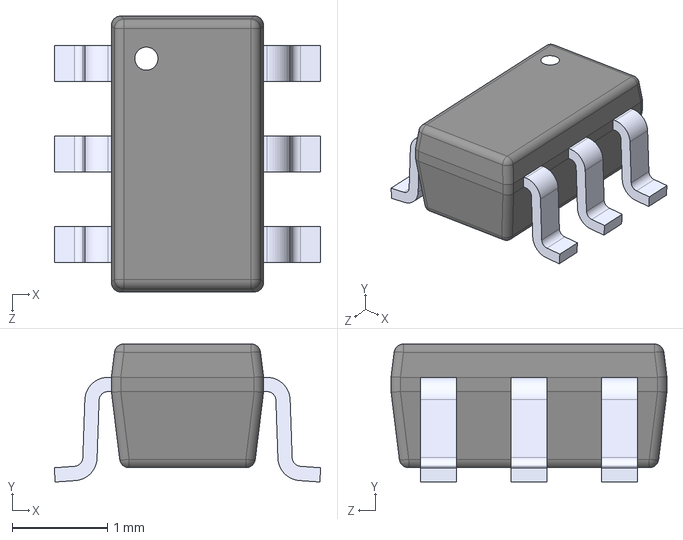
[picture p5: CAD file, 2026-10-24]
hardware/component/SN74LVC1T45DBVR/SN74LVC1T45DBVR.step
2.80 x 1.45 x 2.90 mm
