KK153402/RP2040_FamicomRomdumper/hardware/component/TPS2051CDBVT/TPS2051CDBVT.STEP

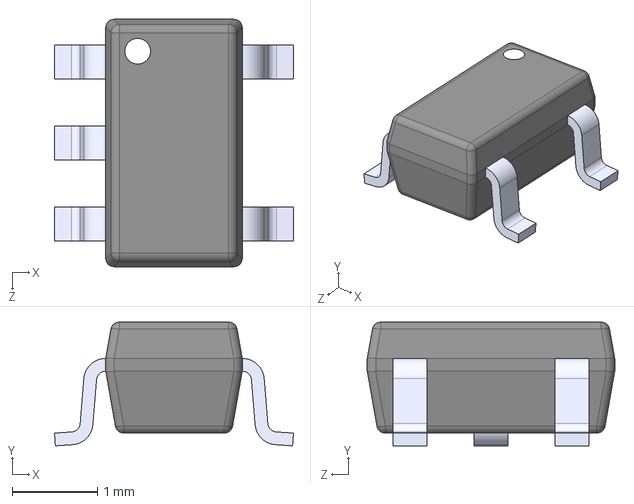
[picture p6: CAD file, 2026-10-24]
hardware/component/TPS2051CDBVT/TPS2051CDBVT.STEP
2.80 x 1.45 x 2.90 mm
