KK153402/RP2040_FamicomRomdumper/hardware/Famicom1_ver2.pdf

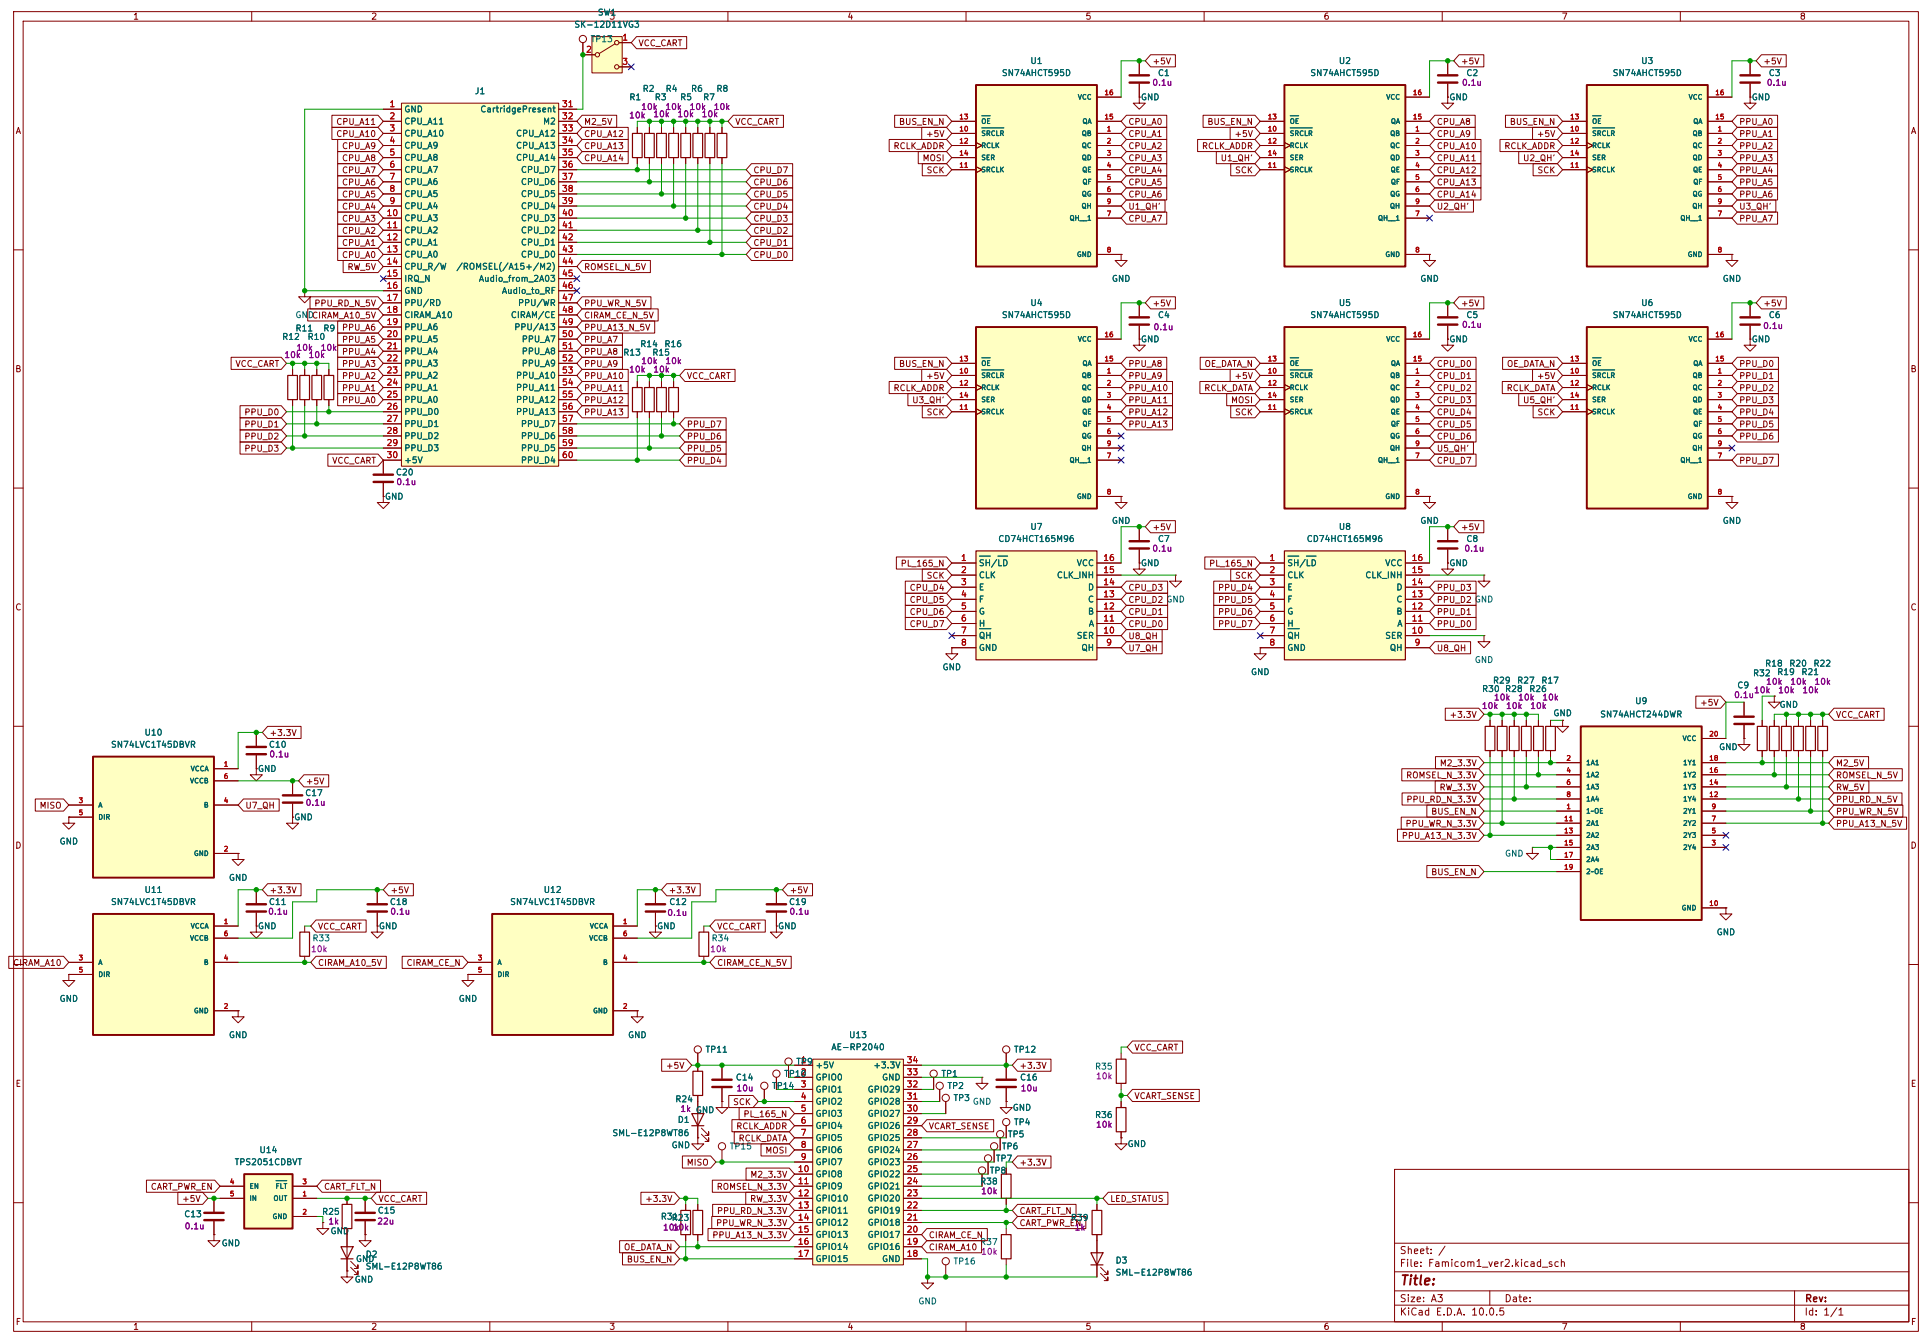
[picture p7: page 1]

1A2 4 | 16 16
1A3 6 | 14 14
1A4 8 | 12 12
1~OE 1
2A1 11 | 7 7

Size: A3 | Rev: | F Date:
KiCad E.D.A. 10.0.5 | Id: 1/1
